weizhen1883/Modular-Robot-Design-MastersThesis/Hardware/RobotBaseModule/BOM.xlsx

Parts | Value | Footprint | Parts Number | Price | Quantity | Total
C1,C2,C3,C9,C12 | 1uF | 0805 | CL21F105ZOCNNNC | $0.10 | 5 | $0.50
C4,C5,C8,C11 | 0.1uF | 0805 | CL21F104ZBCNNNC | $0.10 | 4 | $0.40
C10,C13 | 10uF | 0805 | CL21F106ZQFNNNE | $0.14 | 2 | $0.28
C14,C15 | 1nF | 0805 | CL21C102JBCNNNC | $0.10 | 2 | $0.20
C6,C7 | 220uF | CAP830*830 | UWX0J221MCL1GB | $0.34 | 2 | $0.68
R1,R2 | 47KΩ | 0805 | RC2012F473CS | $0.10 | 2 | $0.20
R3,R4,R5,R6,R7,R8,R9,R10 | 10KΩ | 0805 | RC0805JR-0710KL | $0.10 | 8 | $0.80
R11 | 330Ω | 0805 | RC2012F331CS | $0.10 | 1 | $0.10
D1 |  | 0805 | LG R971-KN-1 | $0.26 | 1 | $0.26
U1 | V7805-2000R | V78-2000R | V7805-2000R | $10.84 | 1 | $10.84
U2 | LM1117-3.3V | SOT-233-4 | LM1117IMPX-3.3/NOPB | $1.04 | 1 | $1.04
U3 | MSP430G2553 | SSOP-20 | MSP430G2553IPW20R | $2.46 | 1 | $2.46
U4 | MSP430G2553 | TSSOP-28 | MSP430G2553IPW28R | $2.73 | 1 | $2.73
U5,U6 | L293DD | SOIC_20 | L293DD | $3.44 | 2 | $6.88
BTN1,BTN2 | SPST SMD | 6*3.5 |  | $0.15 | 2 | $0.30
USB1 | USB1.X/2.0 Standard TypeA TH | USB-A-TH |  | $0.10 | 1 | $0.10
J1 | 2pin 0.200" terminal block | 2PIN_TERMBLOCK_PITCH5.08MM | 1935161 | $0.37 | 1 | $0.37
J2,J3,J6,J7 | 4pin 0.100" header (single dir) | 4PIN_HEADER_VERT_PITCH2.54MM | 640454-4 | $0.18 | 4 | $0.72
J4,J5 | 2pin 0.100" header | 2PIN_HEADER_PITCH2.54MM |  | $0.10 | 2 | $0.20
J8,J9,J10,J11,J13,J14 | 4pin 0.100" header | 4PIN_HEADER_PITCH2.54MM |  | $0.10 | 6 | $0.60
J12 | 7pin 0.100" header (single dir) | 7PIN_HEADER_VERT_PITCH2.54MM | 640456-7 | $0.27 | 1 | $0.27
J15,J16,J17,J18 | 3pin 0.100" header (single dir) | 3PIN_HEADER_VERT_PITCH2.54MM | 640454-3 | $0.16 | 1 | $0.16
 | CONN HOUS 3POS 0.100 |  | 0022013037 | $0.19 | 4 | $0.76
 | CONN HOUS 4POS 0.100 |  | 0022013047 | $0.20 | 4 | $0.80
 | CONN HOUS 7POS 0.100 |  | 0022013077 | $0.36 | 1 | $0.36
 |  |  |  |  | Total: | $29.19
