weizhen1883/Modular-Robot-Design-MastersThesis/Hardware/RobotBaseModule/RobotBaseModule.brd

## EAGLE design Hardware/RobotBaseModule/RobotBaseModule.brd (2016-03-15)

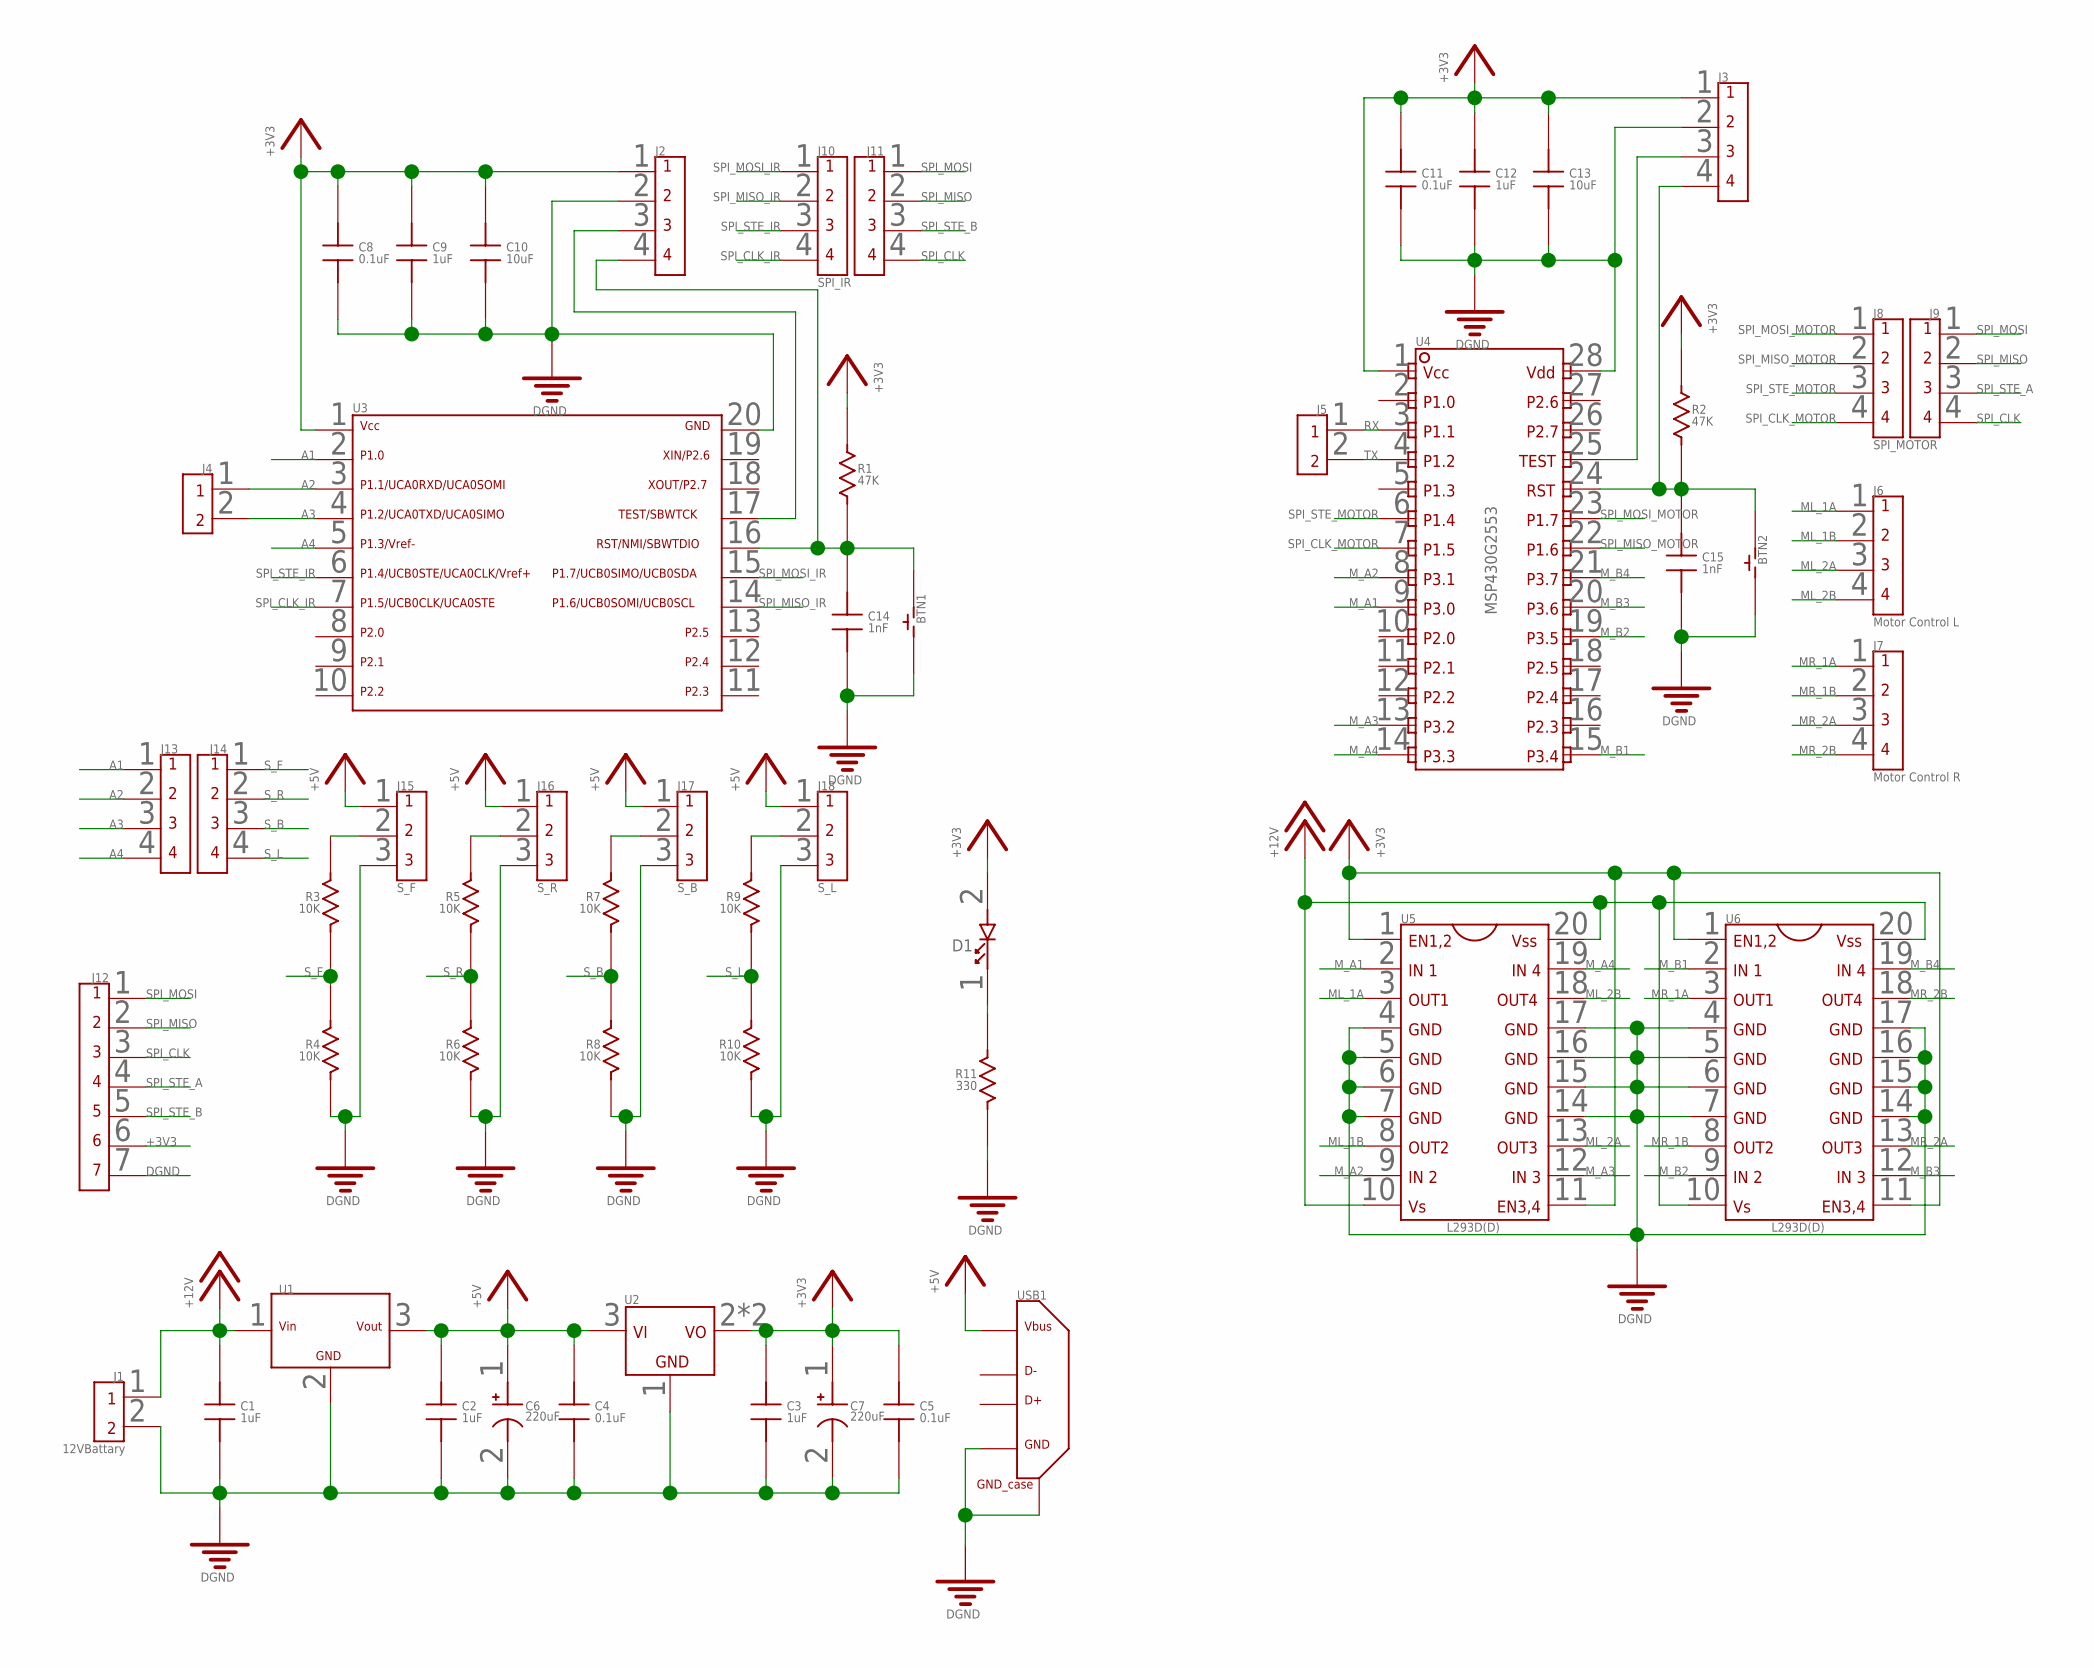
[picture p1: schematic RobotBaseModule.sch]

Parts:
BTN1, BTN2: BTN_NORMAL_OFF_6_3.5_SMD; BTN_6_3.5_SMD
C1, C2, C3, C9, C12: 1uF; 0805
C4, C5, C8, C11: 0.1uF; 0805
C6, C7: 220uF; CAP_830_830
C10, C13: 10uF; 0805
C14, C15: 1nF; 0805
D1: LED_0805; 0805DIODE
J1: 12VBattary; 2PIN_TERMBLOCK_PITCH5.08MM
J2, J3: 4PIN_HEADER_VERT_PITCH2.54MM_TH
J4, J5: 2PIN_HEADER_PITCH2.54MM_TH
J6: Motor Control L; 4PIN_HEADER_VERT_PITCH2.54MM_TH
J7: Motor Control R; 4PIN_HEADER_VERT_PITCH2.54MM_TH
J8: SPI_MOTOR; 4PIN_HEADER_PITCH2.54MM_TH
J9, J11, J13, J14: 4PIN_HEADER_PITCH2.54MM_TH
J10: SPI_IR; 4PIN_HEADER_PITCH2.54MM_TH
J12: 7PIN_HEADER_VERT_PITCH2.54MM_TH
J15: S_F; 3PIN_HEADER_VERT_PITCH2.54MM_TH
J16: S_R; 3PIN_HEADER_VERT_PITCH2.54MM_TH
J17: S_B; 3PIN_HEADER_VERT_PITCH2.54MM_TH
J18: S_L; 3PIN_HEADER_VERT_PITCH2.54MM_TH
R1, R2: 47K; 0805
R3, R4, R5, R6, R7, R8, R9, R10: 10K; 0805
R11: 330; 0805
U1: V78-2000R
U2: LM1117_SOT-223-4; SOT-233-4
U3: MSP430G2X53/G2X13_SSOP20; SSOP-20
U4: MSP430G2553; TSSOP-28
U5, U6: L293D(D)_ST_SMD; SOIC_20
USB1: USB-1.X/2.0-STANDARDTYPEA-TH; USB-A-TH

Connections:
+3V3: C3.1, C5.1, C7.1, C8.1, C9.1, C10.1, C11.1, C12.1, C13.1, D1.2, J2.1, J3.1, J12.6, R1.1, R2.1, U2.2 (VOUT), U2.4 (VOUT), U3.1, U4.1, U5.1, U5.11, U6.1, U6.11
+5V: C2.1, C4.1, C6.1, J15.1, J16.1, J17.1, J18.1, U1.3 (VOUT), U2.3 (VIN), USB1.1 (VBUS)
+12V: C1.1, J1.1, U1.1 (VIN), U5.10, U5.20, U6.10, U6.20
A1: J13.1, U3.2
A2: J4.1, J13.2, U3.3
A3: J4.2, J13.3, U3.4
A4: J13.4, U3.5
DGND: BTN1.2, BTN2.2, C1.2, C2.2, C3.2, C4.2, C5.2, C6.2, C7.2, C8.2, C9.2, C10.2, C11.2, C12.2, C13.2, C14.2, C15.2, J1.2, J2.2, J3.2, J12.7, J15.3, J16.3, J17.3, J18.3, R4.2, R6.2, R8.2, R10.2, R11.2, U1.2 (GND), U2.1 (GND), U3.20, U4.28, U5.4, U5.5, U5.6, U5.7, U5.14, U5.15, U5.16, U5.17, U6.4, U6.5, U6.6, U6.7, U6.14, U6.15, U6.16, U6.17, USB1.4 (GND), USB1.CASE1 (GND_CASE), USB1.CASE2 (GND_CASE)
ML_1A: J6.1, U5.3
ML_1B: J6.2, U5.8
ML_2A: J6.3, U5.13
ML_2B: J6.4, U5.18
MR_1A: J7.1, U6.3
MR_1B: J7.2, U6.8
MR_2A: J7.3, U6.13
MR_2B: J7.4, U6.18
M_A1: U4.9, U5.2
M_A2: U4.8, U5.9
M_A3: U4.13, U5.12
M_A4: U4.14, U5.19
M_B1: U4.15, U6.2
M_B2: U4.19, U6.9
M_B3: U4.20, U6.12
M_B4: U4.21, U6.19
unnamed: J3.3, U4.25
unnamed: J2.3, U3.17
unnamed: BTN1.1, C14.1, J2.4, R1.2, U3.16
unnamed: BTN2.1, C15.1, J3.4, R2.2, U4.24
unnamed: J15.2, R3.1
unnamed: D1.1, R11.1
unnamed: J16.2, R5.1
unnamed: J17.2, R7.1
unnamed: J18.2, R9.1
RX: J5.1, U4.3
SPI_CLK: J9.4, J11.4, J12.3
SPI_CLK_IR: J10.4, U3.7
SPI_CLK_MOTOR: J8.4, U4.7
SPI_MISO: J9.2, J11.2, J12.2
SPI_MISO_IR: J10.2, U3.14
SPI_MISO_MOTOR: J8.2, U4.22
SPI_MOSI: J9.1, J11.1, J12.1
SPI_MOSI_IR: J10.1, U3.15
SPI_MOSI_MOTOR: J8.1, U4.23
SPI_STE_A: J9.3, J12.4
SPI_STE_B: J11.3, J12.5
SPI_STE_IR: J10.3, U3.6
SPI_STE_MOTOR: J8.3, U4.6
S_B: J14.3, R7.2, R8.1
S_F: J14.1, R3.2, R4.1
S_L: J14.4, R9.2, R10.1
S_R: J14.2, R5.2, R6.1
TX: J5.2, U4.4

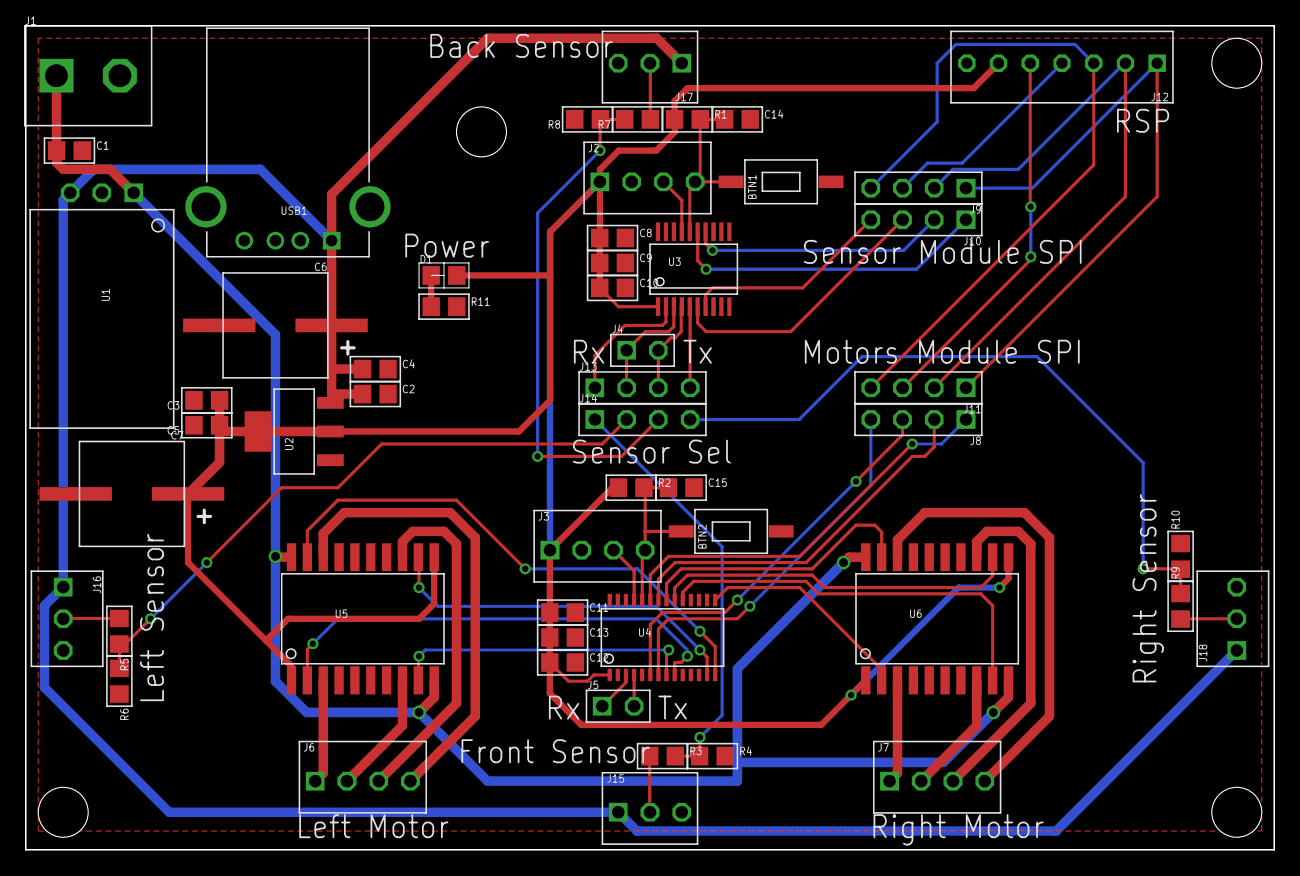
[picture p2: board RobotBaseModule.brd from above]

Board: 2 copper layers, 100.0 x 66.0 mm, 54 parts (0 on the bottom side), 52 nets.
