weizhen1883/Modular-Robot-Design-MastersThesis/Hardware/CustomModule/RaspberryPiSocket.brd

## EAGLE design Hardware/CustomModule/RaspberryPiSocket.brd (2016-03-15)

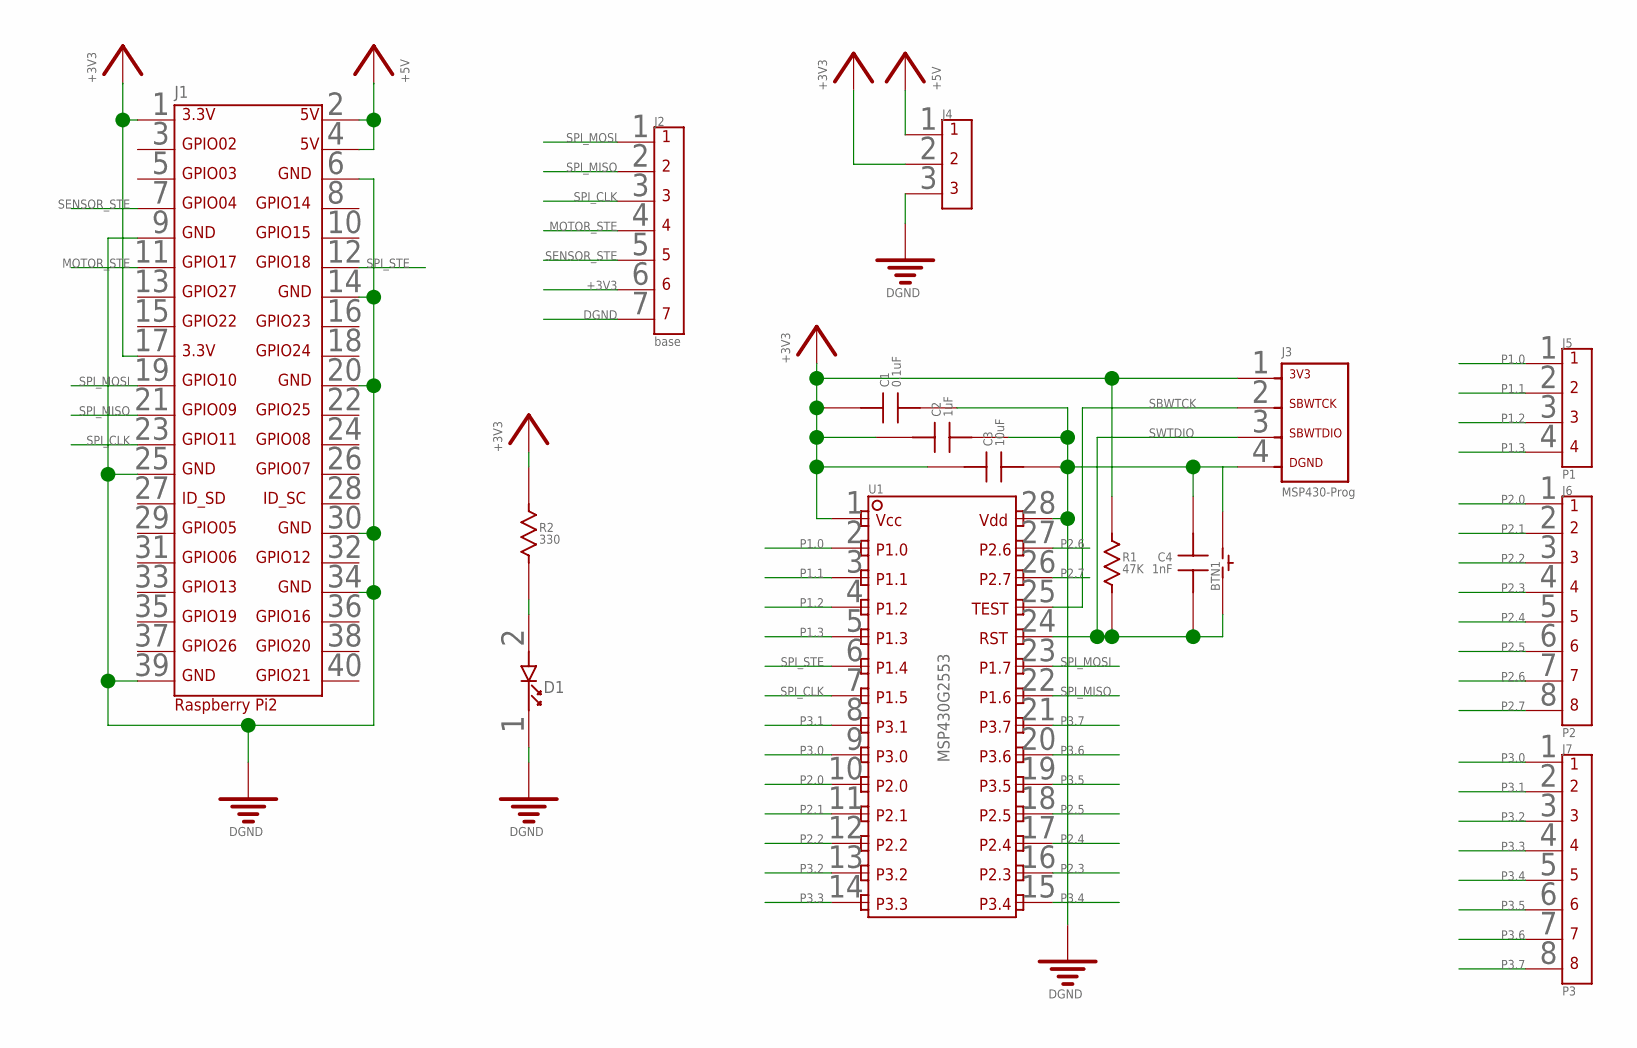
[picture p3: schematic RaspberryPiSocket.sch]

Parts:
BTN1: BTN_NORMAL_OFF_6_3.5_SMD; BTN_6_3.5_SMD
C1: 0.1uF; 0805
C2: 1uF; 0805
C3: 10uF; 0805
C4: 1nF; 0805
D1: LED_0805; 0805DIODE
J1: RPI2
J2: base; 7PIN_HEADER_VERT_PITCH2.54MM_TH
J3: MSP430-PROG_NORMAL; 4PIN_HEADER_PITCH2.54MM_TH
J4: 3PIN_HEADER_PITCH2.54MM_TH
J5: P1; 4PIN_HEADER_PITCH2.54MM_TH
J6: P2; 8PIN_HEADER_PITCH2.54MM_TH
J7: P3; 8PIN_HEADER_PITCH2.54MM_TH
R1: 47K; 0805
R2: 330; 0805
U1: MSP430G2553_24IO_28PIN_TSSOP; TSSOP-28

Connections:
+3V3: C1.1, C2.1, C3.1, J1.1, J1.17, J2.6, J3.1, J4.2, R1.1, R2.1, U1.1
+5V: J1.2, J1.4, J4.1
DGND: BTN1.2, C1.2, C2.2, C3.2, C4.1, D1.1, J1.6, J1.9, J1.14, J1.20, J1.25, J1.30, J1.34, J1.39, J2.7, J3.4, J4.3, U1.28
MOTOR_STE: J1.11, J2.4
unnamed: D1.2, R2.2
P1.0: J5.1, U1.2
P1.1: J5.2, U1.3
P1.2: J5.3, U1.4
P1.3: J5.4, U1.5
P2.0: J6.1, U1.10
P2.1: J6.2, U1.11
P2.2: J6.3, U1.12
P2.3: J6.4, U1.16
P2.4: J6.5, U1.17
P2.5: J6.6, U1.18
P2.6: J6.7, U1.27
P2.7: J6.8, U1.26
P3.0: J7.1, U1.9
P3.1: J7.2, U1.8
P3.2: J7.3, U1.13
P3.3: J7.4, U1.14
P3.4: J7.5, U1.15
P3.5: J7.6, U1.19
P3.6: J7.7, U1.20
P3.7: J7.8, U1.21
SBWTCK: J3.2, U1.25
SENSOR_STE: J1.7, J2.5
SPI_CLK: J1.23, J2.3, U1.7
SPI_MISO: J1.21, J2.2, U1.22
SPI_MOSI: J1.19, J2.1, U1.23
SPI_STE: J1.12, U1.6
SWTDIO: BTN1.1, C4.2, J3.3, R1.2, U1.24

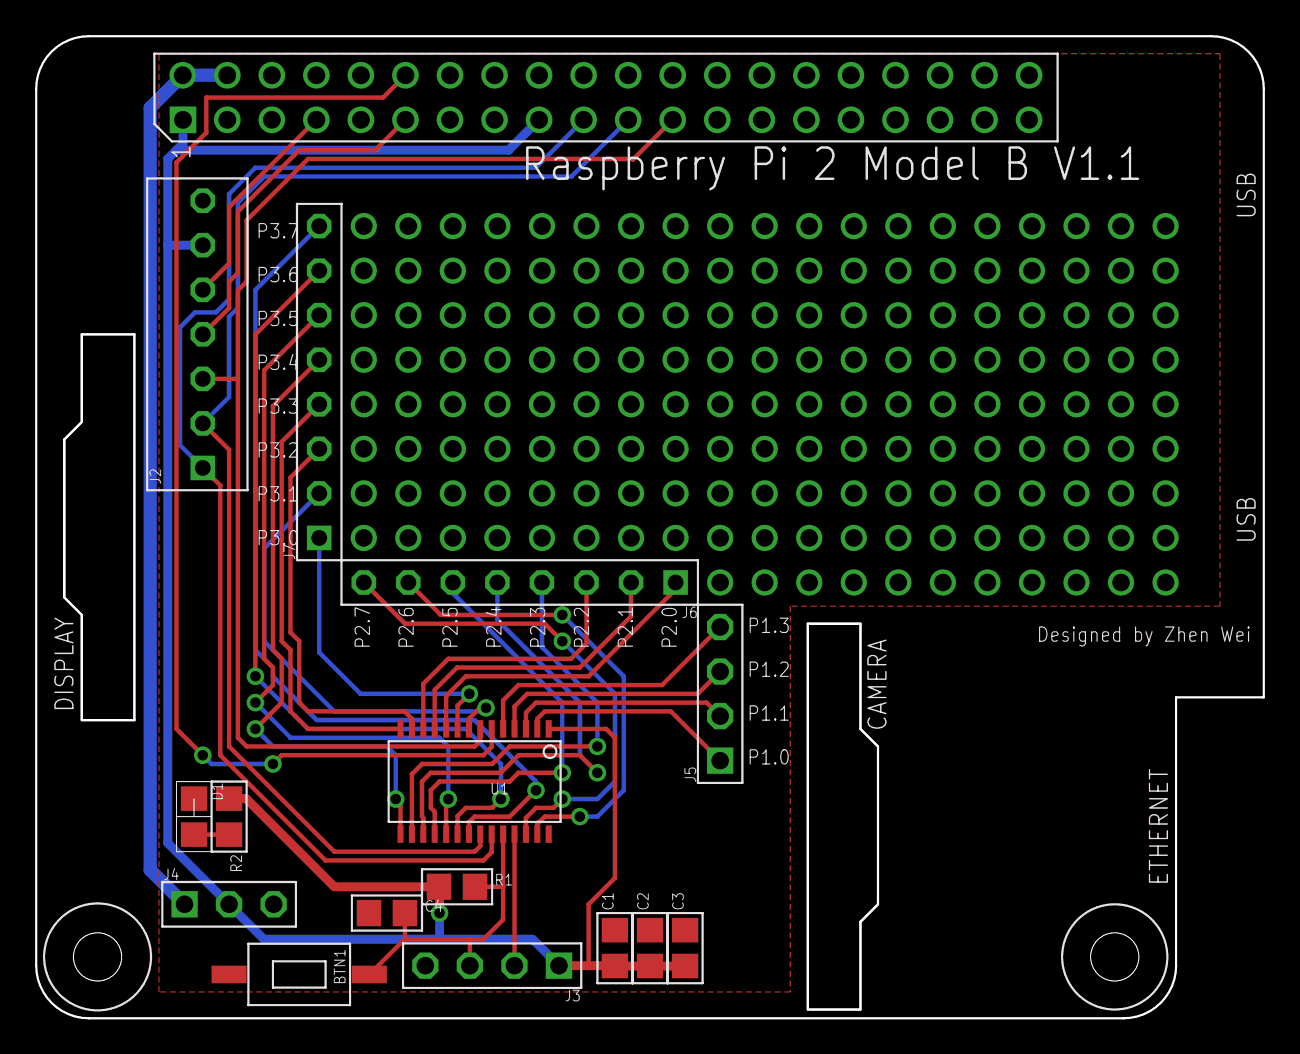
[picture p4: board RaspberryPiSocket.brd from above]

Board: 2 copper layers, 70.0 x 56.0 mm, 16 parts (0 on the bottom side), 32 nets.
