weizhen1883/Modular-Robot-Design-MastersThesis/Firmware/Examples/ObstacleAvoidance/ir_functions.h

#ifndef _IR_FUNCTIONS_H
#define _IR_FUNCTIONS_H

uint16_t Calculate_Front_IR_Value(uint8_t inches);
uint16_t Calculate_Back_IR_Value(uint8_t inches);
uint16_t Calculate_Left_IR_Value(uint8_t inches);
uint16_t Calculate_Right_IR_Value(uint8_t inches);

#endif
