weizhen1883/Modular-Robot-Design-MastersThesis/(commit log)

2016-01-22 move the current msplib code into the resp
2016-01-22 the firmware for Motor_module is ready for test
2016-01-22 the rsp motor lib
2016-01-22 the motor module is done and tested
2016-01-25 starting test the IR sensor module
2016-01-29 the IR sensor module firmware closely done
2016-01-29 done the rasp lib for ir sensor
2016-02-01 Hardware V1.0: Upload all of the files has been done
    [IRSensorModule.brd, IRSensorModule.sch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]
2016-02-01 Hardware V2.0: The base module is ready for test
    [IRSensorModule.brd, IRSensorModule.sch, RobotBaseModule.brd, RobotBaseModule.sch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]
2016-02-11 change the IR sensor side
2016-02-12 Obstacle Avoidance: the robot can go and stop when it sence the obstacles
    [ir_functions.c, ir_functions.h, ir_sensor_api.c, ir_sensor_api.h, main.c, stepper_motor_api.c, stepper_motor_api.h]
2016-02-12 the base module has been test and most of the feature works, but the two in one spi port still has issues
    [BOM.xlsx]
2016-02-12 the custom Module is ready for testing
    [RaspberryPiSocket.brd, RaspberryPiSocket.sch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]
2016-03-15 remove the raspberry pi socket which will instand by custom module
    [RaspberryPiSocket.brd, RaspberryPiSocket.sch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]
2016-03-15 fix the time delay in rsplib
    [ir_sensor_api.c]
2016-03-16 fix the example issue
    [main.c]
